ybbbby/Integrated-Mechatronic-Project/README.md

## This repo contains IMP's requirements, our solution code and our final group report.
basically IMP require student to build a robot which can follow a 10mA sinewave wire(hiden in the ground)
