ybbbby/Integrated-Mechatronic-Project/Final Report.pdf

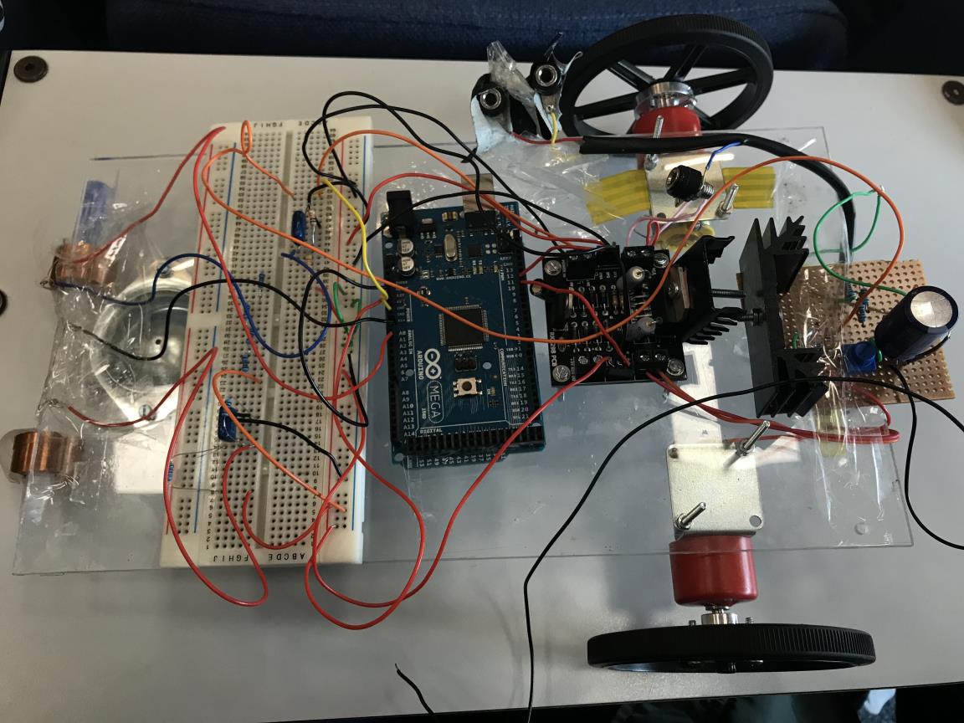
[picture p30: figure]
